burnoutlabs/airbrakes-SR/README.md

# airbrakes-SR

This is the repository for the Western Engineering Rocketry Team's design of an airbrakes system.

**Status: the airbrakes never deployed in flight.** See [docs/status.md](docs/status.md) for why, and for the state each subsystem reached.

## Provenance

- This repository (burnoutlabs/airbrakes-SR) is the canonical copy. It is a standalone copy of [werocketry/airbrakes-SR](https://github.com/werocketry/airbrakes-SR) and is not kept in sync with it; the werocketry original is left as it was.
- The project began as [chasgior214/airbrakes-capstone](https://github.com/chasgior214/airbrakes-capstone), the MME 4499 2023-24 Group 13 capstone (now archived). This repository was split out of it on 2024-04-09 (commit `2a644e5`) and keeps its history.
- Project status: [docs/status.md](docs/status.md).

## Sister Projects

- [werocketry/RocketFlightSim](https://github.com/werocketry/RocketFlightSim): the flight simulator these simulations are built on.
- [burnoutlabs/hpr-flight-computer](https://github.com/burnoutlabs/hpr-flight-computer): the flight computer the design was to use.
- [werocketry/airbrakes-lookuptable-generator](https://github.com/werocketry/airbrakes-lookuptable-generator): the 2025 lookup table for the Hyperion II airbrakes.

## Acronyms of the Trade
| Acronym | Full Name | Description |
|---|---|---|
| AGL | Above Ground Level | |
| COTS | Commercial off-the-shelf | |
| CP | Center of pressure | |
| ESRA | Experimental Sounding Rocket Association  | |
| FOS | Factor of Safety | |
| FS | Factor of Safety | |
| IREC | Intercollegiate Rocket Engineering Competition | Basically SAC. It used to happen somewhere else |
| NM | New Mexico | |
| NMSU | New Mexico State University | The university on whose grounds some parts of SAC are held |
| OR | OpenRocket | |
| .ork | OpenRocket filetype | |
| RSO | Range Safety Officer | The person that gives you permission to launch |
| SA | Spaceport America | The launch site where SAC is hosted |
| SAC | Spaceport America Cup | |
| SRAD | Student researched and designed | |
| VLA | Vertical Launch Area | |
| WERT | Western Engineering Rocketry Team | Also called WE Rocketry |
## License

None yet. This is joint team work, so a license needs the co-authors' agreement; that is tracked in [#4](https://github.com/burnoutlabs/airbrakes-SR/issues/4).
