burnoutlabs/airbrakes-SR/(list of files, cad)

Other CAD files:
mechanical/CAD/components-electrical-ardupro/hall-effect-sensor/Linear Magnetic Hall Effect Switches.SLDASM
mechanical/CAD/airbrakes_CAD_V5_0_0/Airbrake 3-Flap.SLDASM
mechanical/CAD/battery_pack_scad/stl/battery_assem-x1.stl
mechanical/CAD/components-electrical-ardupro/arduino-nicla-sense-me/Nicla Sense v4.stl
mechanical/CAD/components-electrical-ardupro/arduino-pro-portenta-h7/Arduino-Portenta-H7-STEP-A210428.step
mechanical/CAD/components-electrical-ardupro/motor-driver-l298n/MOTOR_DRIVER_L298N.SLDPRT
mechanical/CAD/airbrakes_CAD_V5_0_0/Motor Platform.SLDPRT
mechanical/CAD/battery_pack_scad/stl/battery_assem_x3.stl
mechanical/CAD/components-electrical-ardupro/arduino-nicla-sense-me/Nicla Sense.step
mechanical/CAD/airbrakes_CAD_V5_0_0/Rivet Pressed.SLDPRT
mechanical/CAD/airbrakes_CAD_V5_0_0/Platform Spacers.SLDPRT
mechanical/CAD/airbrakes_CAD_V5_0_0/Shell Epoxy Platform.SLDPRT
mechanical/CAD/airbrakes_CAD_V5_0_0/Shell Epoxy Platform - No Standoffs.SLDPRT
mechanical/CAD/airbrakes_CAD_V5_0_0/Rocket Shell - 3.SLDPRT
mechanical/CAD/airbrakes_CAD_V5_0_0/Coupler tube.SLDPRT
mechanical/CAD/airbrakes_CAD_V5_0_0/Bottom Platform.SLDPRT
mechanical/CAD/airbrakes_CAD_V5_0_0/Top Hinge.SLDPRT
mechanical/CAD/airbrakes_CAD_V5_0_0/Flap Support.SLDPRT
mechanical/CAD/airbrakes_CAD_V5_0_0/Top-Bottom Platform.SLDPRT
mechanical/CAD/airbrakes_CAD_V5_0_0/Push Rod - 3.SLDPRT
mechanical/CAD/airbrakes_CAD_V5_0_0/Flap.SLDPRT
electrical/dmats_hw_v1_0/external-components/ABX00042/ABX00042.step
mechanical/CAD/airbrakes_CAD_V5_0_0/6338K563_Oil-Embedded Flanged Sleeve Bearing.SLDPRT
mechanical/CAD/airbrakes_CAD_V5_0_0/94622A215_Cadmium-Plated Steel Hex Head Screw.SLDPRT
mechanical/CAD/airbrakes_CAD_V5_0_0/94887A363_Low-Profile Binding Barrels and Screws.SLDPRT
mechanical/CAD/airbrakes_CAD_V5_0_0/95075A340_Plastic Externally Threaded Precision Acme Nut.SLDPRT
mechanical/CAD/airbrakes_CAD_V5_0_0/95082A641_Precision Acme Flange.SLDPRT
mechanical/CAD/airbrakes_CAD_V5_0_0/97763A431_18-8 Stainless Steel Button Head Hex Drive Screws.SLDPRT
mechanical/CAD/airbrakes_CAD_V5_0_0/Lead Screw.SLDPRT
mechanical/CAD/airbrakes_CAD_V5_0_0/Rod Nut.SLDPRT
mechanical/CAD/components-electrical-ardupro/arduino-nicla-sense-me/Nicla Sense.iges
mechanical/CAD/components-electrical-ardupro/arduino-nicla-sense-me/Nicla Sense.obj
