burnoutlabs/airbrakes-SR/(commit log)

2026-11-06 docs: mark repo as the canonical standalone copy and fix stale links
    [dmat_comain.ino, flight_comp_main.ino]
2026-11-06 docs(electrical): record what the kicad backups and autosaves hold before removal
2026-11-06 chore(electrical): remove kicad backups, autosaves and caches
    Keeps the only copy of the hall effect sensor sheet, previously an autosave, as hall_effect_sensor.kicad_sch.
    [hall_effect_sensor.kicad_sch]
2026-11-06 docs(mechanical): describe the mould lfs pointer issue without assuming its fix
2026-11-06 chore(lfs): match lfs patterns case-insensitively and cover media, archives and cad exports
2026-11-06 docs(electrical): describe kicad leftovers in terms that hold before and after cleanup
2026-11-07 chore: test the barometric lag explanation and convert tracked cad/media to lfs (#28)
    * docs(flight-sims): test the barometric lag explanation against the logs
    Adds baro_lag_check.py (standard library, runs under uv or python3),
    which compares ISA barometric altitude with double-integrated axial
    acceleration in each AltOS log, and a write-up of the result. On the 2022
    Prometheus flight the barometer reads about 360 m low at burnout, but
    the velocity overshoot and disagreeing delay estimates do not fit a
    0.8 s lag. The flight_sims README now points to the write-up.
    * chore(lfs): store tracked cad and media files as lfs pointers
    Renormalizes the index so the 59 files that match .gitattribut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
    [6338K563_Oil-Embedded Flanged Sleeve Bearing.SLDPRT, 94622A215_Cadmium-Plated Steel Hex Head Screw.SLDPRT, 94887A363_Low-Profile Binding Barrels and Screws.SLDPRT, 95075A340_Plastic Externally Threaded Precision Acme Nut.SLDPRT, 95082A641_Precision Acme Flange.SLDPRT, 97763A431_18-8 Stainless Steel Button Head Hex Drive Screws.SLDPRT, ABX00042.step, Airbrake 3-Flap.SLDASM]
